longqijun/linetrace/自己测试用赛道.jpg

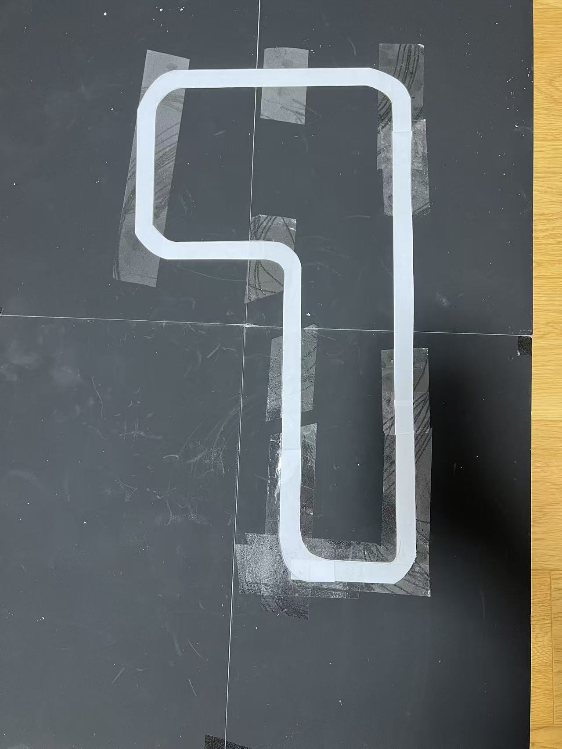
自己测试用赛道.jpg
