longqijun/linetrace/公司比赛用赛道.jpg

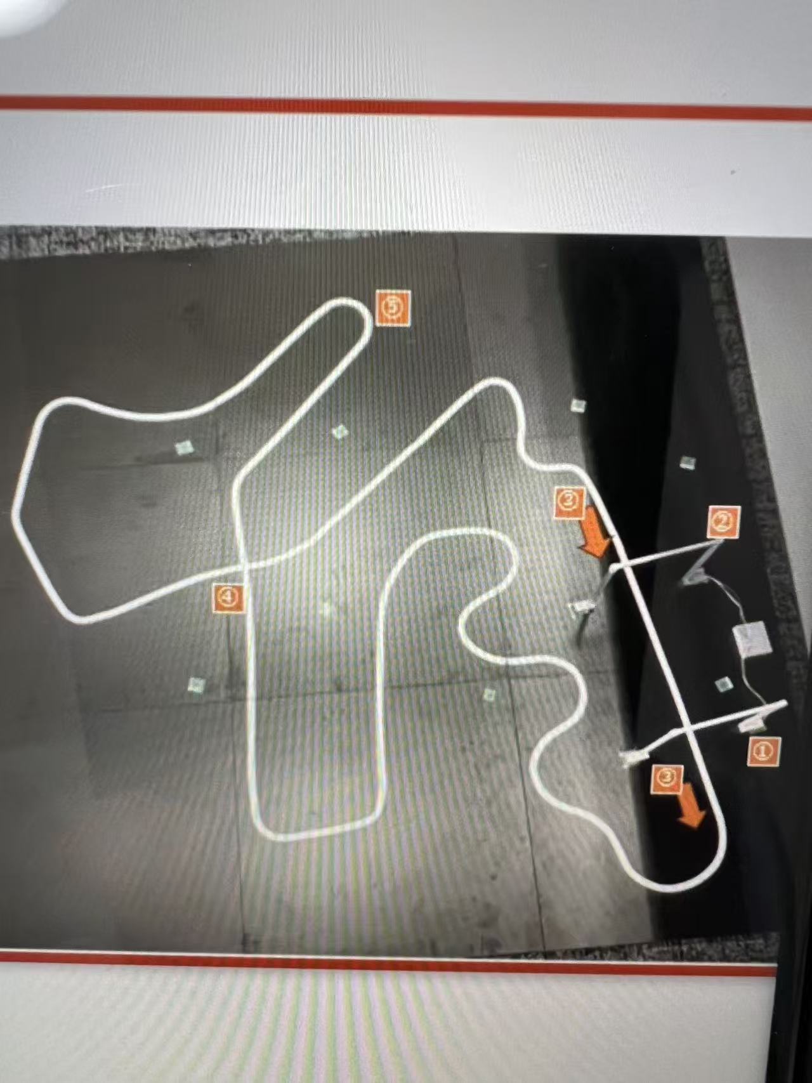
公司比赛用赛道.jpg
