longqijun/linetrace/doc/README.md

# 文档索引

巡线小车项目文档，按类别整理。原始代码在仓库根的 `sensor_debug/`。

## 设计（架构与算法）— `设计/`
| 文档 | 内容 |
|---|---|
| [设计说明](设计/设计说明.md) | 项目总体设计说明 |
| [主程序到bangbang算法调用流程](设计/主程序到bangbang算法调用流程.md) | 主循环到巡线算法的调用链 |
| [8路传感器方案](设计/8路传感器方案.md) | 8 路传感器排布、二值/加权判定方案 |
| [8路模拟PID算法](设计/8路模拟PID算法.md) | 基于模拟量加权位置的 PID 方案 |
| [PID算法分析](设计/PID算法分析.md) | PID 参数与行为分析 |
| [BANGBANG算法修改方案](设计/BANGBANG算法修改方案.md) | 中心直行+对称三档的 bang-bang 改造方案 |
| [LOG精简方案](设计/LOG精简方案.md) | 内存日志格式与精简方案（modeCode/事件行等） |

## 硬件（电机 / 传感器 / 机械）— `硬件/`
| 文档 | 内容 |
|---|---|
| [如何判断当前有没有机械延迟](硬件/如何判断当前有没有机械延迟.md) | 机械 vs 软件延迟的判定实验；减速箱慢一拍分析；齿轮比 114.7/38.2/12.7 选择 |
| [电机选型_空心杯无刷](硬件/电机选型_空心杯无刷.md) | 空心杯/无刷电机选型，中/日品牌+链接 |
| [传感器前探设计](硬件/传感器前探设计.md) | 前探为何数据更乱、单排甜区、双排方案、找线改法 |
| [电池选型](硬件/电池选型.md) | 18650 双电源电池方案 |

## 调试（记录与排障）— `调试/`
| 文档 | 内容 |
|---|---|
| [调试记录](调试/调试记录.md) | **主进展记录**：从 log13 到 log20 的调试历程、结论与下一步 |
| [软件问题解决](调试/软件问题解决.md) | 软件问题排查记录 |

## 日志分析 — `日志分析/`
每份 `logNN.txt` 是抓取的原始数据，`logNN分析.md` 是对应分析。关键脉络（详见 [调试记录](调试/调试记录.md)）：

| 分析 | 结论要点 |
|---|---|
| [log13分析](日志分析/log13分析.md) | 老 bang-bang 从不进 STRAIGHT，居中被判 CROSS → 发散丢线 |
| [log14分析](日志分析/log14分析.md) | 改中心直行后仍漂；三根因（slew/找线反转/激进档） |
| [log15分析](日志分析/log15分析.md) | slew 600→5000 后直线不丢；**证明软件延迟是主因** |
| [log16分析](日志分析/log16分析.md) | PID 直线笔直，err ±0.33 内 —— **直线达标** |
| [log17分析](日志分析/log17分析.md) | 弯道 bang-bang 每弯必险；含**弯道降速方案A**详解 |
| [log18分析](日志分析/log18分析.md) | 方案A 第一版仍冲出；削弱了发卡内轮 |
| [log19分析](日志分析/log19分析.md) | 方案A 第二版（minpwm）按设计工作，但动不了 sharp/发卡 |
| [log20分析](日志分析/log20分析.md) | 跑最久 67s，但 sharpspeed 被 minpwm 吃掉无效；**软件到顶** |
| 早期 | [log4](日志分析/log4-分析报告.md)、[log5](日志分析/log5分析.md)、[log6](日志分析/log6分析.md)、[log10](日志分析/log10分析.md)、[log11](日志分析/log11分析.md)、[bangbang/](日志分析/bangbang/) |

## 其他 — `其他/`
| 文档 | 内容 |
|---|---|
| [WIFI_PLAN](其他/WIFI_PLAN.md) | WiFi 相关计划 |

---
> 当前结论（截至 log20）：直线已用 PID 攻克；弯道受**电机静摩擦死区**限制，软件方案A 动不了 sharp/发卡，重心转向"治盲目找线 + 传感器前探 + 降死区/齿轮比（硬件）"。详见 [调试记录](调试/调试记录.md)。
