longqijun/linetrace/doc/硬件/电池选型.md

# 电池选型：18650 → 干电池 替代方案

## 背景

比赛规则不允许使用锂电池（18650），只能用**干电池**。本文给出替代方案和选购要点。

---

## 现有供电架构（双 18650）

来自 `设计说明.md`，本项目是**双电池、两路独立供电**：

| 路 | 电池 | 中间环节 | 负载 |
|---|---|---|---|
| 逻辑路 | 18650 ①（3.7V） | 升压模块 → 5V | ESP32 + 8路传感器 |
| 电机路 | 18650 ②（3.7V） | DRV8833 直连 VM | 电机 |

**为什么要两路分开**：电机启停/堵转时电流冲击大、电压会瞬间下陷，如果和 ESP32 共用一块电池，会把逻辑电压拉低导致 ESP32 复位/死机。所以电机和逻辑各用一块电池隔离——**换干电池后这个隔离必须保留**。

关键器件电压范围：
- **电机**：额定 1.5~3V（原装设计就是 2 节 AA = 3V）
- **DRV8833 VM**：2.7~10.8V（很宽，不是瓶颈）
- **升压模块**：输入几伏都能升到 5V，4.5V 输入升 5V 是很小的升压、效率高

---

## 干电池替代方案（推荐）

用 **单3（5号）AA 干电池**，每路一个电池盒：

| 路 | 电池盒 | 电压 | 说明 |
|---|---|---|---|
| 逻辑路 | 3×AA | 4.5V | → 沿用现有升压模块升到 5V（4.5→5V 很轻松） |
| 电机路 | 3×AA | 4.5V | → 直连 DRV8833 VM，替代原 3.7V 的 18650 |

**为什么是 3 节（4.5V）而不是别的：**
- 3×AA=4.5V 最接近原来 18650 的 3.7V（新电池空载约 4.7V，带负载下陷后落到 ~3.5~4V），动力手感和原来接近；
- 电机额定 3V，4.5V 约 1.5 倍，和原来 3.7V 的超压幅度差不多，**不比现在更激进**，DRV8833 也在安全区；
- 4 节（6V）= 电机额定 2 倍，堵转电流风险大（急转内轮反转那一下最容易过流跳闸/发热），**不推荐**；
- 2 节（3V）正好等于电机额定，最保护电机，但比原来 3.7V 弱一点，可能觉得没劲。

> ✅ **所以你要买的就是「3 节 5 号（AA）电池盒」，一共 2 个**（逻辑路、电机路各一个）。

---

## ⚠️ 关键注意：干电池带电机的「掉压」问题

这是锂电池换干电池最大的坑，一定要知道：

- **碱性干电池内阻高**，电机堵转/急转时电流冲到 2A 以上（`设计说明.md` 实测 3V 时堵转 ~2.1A），此时电压会明显下陷，电机变没劲、电池也掉得快。
- 缓解办法：
  1. **软件限幅**：把 `motor_module.cpp` 的 `motor_level_to_pwm` PWM 上限压低（比如封顶 ~180 而不是 255），减小峰值电流冲击——`设计说明.md` 里已经讨论过这个折中；
  2. **电机路用容量大的电池**：5号(AA) 是平衡之选；如果动力/续航不够，电机路可换 **2号(C) 或 1号(D)** 干电池盒（内阻更低、能出更大电流），代价是更大更重；
  3. 用**新的、好的碱性电池**，电机路掉得比逻辑路快，注意及时换。

---

## 备选：镍氢充电电池（NiMH，需先确认规则）

如果规则里「不能用锂电池」但**允许镍氢**（NiMH 是可充电，但不是锂），那它其实比碱性干电池更适合带电机：
- 内阻低、能扛大电流、掉压小，很适合电机负载；
- 单节标称 1.2V，**4 节 = 4.8V**（接近本方案的 4.5V），电池盒买 4 节的。

> ❗ 但你说「只能是干电池」，NiMH 属于充电电池、可能不算干电池——**买之前先跟规则/裁判确认镍氢是否允许**。允许就优先用它，不允许再用碱性。

---

## 选购要点 + 链接

买电池盒时挑这些特征：

- **3 节 5 号（AA）串联**，输出 4.5V（这类盒子默认就是串联）
- **带开关**（方便整车断电，省得每次拔电池）
- **带引线**（红黑线，直接焊/接线）或 **带 DC 插头**（5.5×2.1mm，看你板子接口）

淘宝 / 京东搜索链接（搜索页比单品链接稳，不会因为下架失效）：

- 淘宝：<https://s.taobao.com/search?q=3节5号电池盒+带开关>
- 京东：<https://search.jd.com/Search?keyword=3节5号电池盒%20带开关>
- 关键词也可以搜：`3节AA电池盒 带开关 引线`、`4.5V电池盒 DC插头`

如果决定电机路用大电池：

- 淘宝：<https://s.taobao.com/search?q=3节1号电池盒+带开关>（1号=D，大电流）
- 或 2 号(C)：`3节2号电池盒`

镍氢方案（4 节 4.8V）：

- 淘宝：<https://s.taobao.com/search?q=4节5号充电电池盒>

---

## 小结

| 场景 | 买什么 | 数量 |
|---|---|---|
| 标准方案（碱性干电池） | 3 节 5 号(AA) 电池盒，带开关 | 2 个（逻辑/电机各一） |
| 电机没劲/续航短 | 电机路换 3 节 2 号(C) 或 1 号(D) 盒 | 电机路 1 个 + 逻辑路 3×AA 1 个 |
| 规则允许镍氢 | 4 节 5 号盒 + NiMH 电池 | 2 个 |

换电后建议先按上面「软件限幅」把 PWM 上限压低再上车，避免干电池掉压 + 急转过流。
