longqijun/linetrace/doc/日志分析/log31分析.md

# log31 分析（PID kp80/kd20：目前最好的一套）

> 背景：log30(kp130) 过转变差后，回到 **kp=80、把 kd 拉高到 20**（新建档 `algo_pid`）。参数：PID speed15, kp80, ki0, **kd20**, slew5000（base≈96）。用户：**这套参数还好一点。**

## 一、✅ 目前最好的结果
| 指标 | BB(log21-27) | log28 kp80/kd15 | log29 kp80/kd15 | log30 kp130/kd6 | **log31 kp80/kd20** |
|---|---|---|---|---|---|
| 结局 | 60~130s | ~2s 冲飞 | 80s | 16s | **129s（80s无撞停）** |
| **LOST 占比** | 19.6~22.7% | 45% | 29.8% | 52.3% | **18.5%** |
| LOST_STOP | 有 | 有 | 少 | 有 | **0（logged 80s）** |
| 外轮封顶 | — | ✗(226) | ✓96 | ✓96 | ✓96 |

- **LOST 18.5% 是所有跑（PID+BB）里最低的**，且 logged 80s 内**一次都没撞停**，车跑到 129s。
- 丢线不再"全在左"：**LOST_L=699、LOST_R=819**，基本平衡——说明左弯现在**跟得住**了，剩下的丢线是小幅过冲（左右都有一点），而不是"每个左弯必翻"。

## 二、为什么 kp80/kd20 比之前都好
- **kp 保持中等(80)**：不像 kp130 那样稳态过转（不会一进弯就猛掰过头）。
- **kd 拉高到 20 = 预判式转向**：kd 对"误差变化率"响应。**线快速往边缘扫时（=正在进弯），微分尖峰把内轮狠狠反转**（本趟内轮瞬时到 **-173**），给一个"该使劲时才使劲"的强 pivot；而 err 稳定时又很温和。
- **外轮封顶让高 kd 变安全**：log28 时 kd 尖峰会把**外轮**顶到 2 倍多 base（加速冲飞）；现在外轮封顶 96，**同样的 kd 尖峰只作用在内轮（反转）**——正好是"进弯狠掰内轮、外轮不加速"的理想动作。所以**"外轮封顶 + 高 kd"是这次能跑好的关键组合**。

一句话：kp80 给温和的稳态跟随，kd20 给进弯瞬间的强反转 pivot，外轮封顶保证这股劲只用来转、不用来冲。

## 三、仍有空间
- LOST 18.5% 虽是最低，但还不算"稳当"（理想是个位数）。可微调再往下压：
  - kp 小幅上探（80→90）看弯道是否更跟得住、会不会又过转；
  - 或 speed 略降（15→13）给点裕量；
  - kd 已经 20，别再大幅加（太大对噪声敏感、会发毛）。
- 一次只动一个，跑一趟看 LOST%。
- 缓冲 80s 写满看不到后半程；想看完整 129s 一趟可临时 `lograte 15`。

## 四、结论
**`kp80 / kd20 / 外轮封顶` 是目前最优基线**：LOST 18.5%（最低）、80s 无撞停、左弯跟得住。机理=温和 kp + 高 kd 预判反转 + 外轮封顶。下一步在此基础上小幅微调（kp→90 或 speed→13）把 LOST 压到个位数即可。

---
相关：`log30分析.md`(kp130过转)、`log29分析.md`(kp80欠转)、`../问题/02_PID外轮boost加速冲弯.md`(外轮封顶)
