longqijun/linetrace/doc/日志分析/log26-27分析.md

# log26 / log27 分析（speed 18 vs 19 对比，loop 卡顿修复后）

> 背景：用**算法管理器**新建了两个命名档做速度对比——`bb_18`(id3, speed18) 与 `bb_19`(id4, speed19)，其余参数相同（turn_ratio=1.0, sharp=-0.4, xsharp=-0.6, shpspeed/hpspeed=1.0, minpwm=70, slew=50000, lograte=10）。算法管理器正好用来做这种 A/B。

## 一、loop 卡顿修复：继续稳固 ✅
| | log26 (spd18) | log27 (spd19) |
|---|---|---|
| H 间隔 ≥40ms（卡顿） | **0** | **0** |
最大 H 间隔都是 10~11ms。修复（去掉 `out()` 的持续 flash 写）在 speed18/19 下依旧零卡顿。

## 二、speed 18 vs 19 对比
| 指标 | log26 `bb_18` | log27 `bb_19` | 趋势 |
|---|---|---|---|
| **LOST 占比** | **19.6%** | **22.0%** | 速度越高丢线越多 |
| LOST_L / LOST_R | 1253 / 763 | 1397 / 861 | 都偏左（见第四节） |
| HAIRPIN(7/8) 次数 | 1834 | **2093** | 越快越容易冲到发卡边缘 |
| STRAIGHT(0) 次数 | 2541 | 2212 | 越快直行占比越少（一直在修正） |
| CROSS(9) | 5 | 4 | cross 收紧有效 |
| logged 97s 内 LOST_STOP | 0 | 0 | 两趟前 97s 都没撞停 |

**结论：speed 19 明显比 18 更 marginal**——丢线率更高（22% vs 19.6%）、发卡更多、直行更少。速度提高必然放大过冲/丢线。**18 比 19 稳一点。**

## 三、两趟都"没撞停"，但看不到结局
- log26：`elapsed=121072ms  duration=96734ms`，缓冲 ~97s（10298 行）写满截断；结尾停在**左发卡**挣扎中（`C0 7 -69 115`），非撞停。车实际跑到 121s。
- log27：`elapsed=135988ms  duration=97168ms`，同样 ~97s 写满；结尾停在**左侧找线**（`00 A -48 121`），非撞停。车实际跑到 136s。
- 前 97s 都没 LOST_STOP，延续 log25"卡顿修复后跟得住"的趋势——但**缓冲截断看不到后半程**，无法确认最终是否撞停。要看完整趟，可临时 `lograte 15~20`。

## 四、值得注意：持续"偏左"
两趟 **LOST_L 都明显多于 LOST_R**（1253:763、1397:861），和之前多次观察一致（第一次漂总偏左、左发卡更难缠）。疑似**轻微左偏**——可能来源：左右轮不一致（传动/PWM 响应）、或最外侧传感器标定。
- **建议单独验证**：原地 `spin left`/`spin right` 各转固定时间比转角；或同 PWM 直行测跑偏方向。若确有固定左偏，`../硬件/如何判断当前有没有机械延迟.md` 方向2（传动比/编码器）值得推进。

## 五、结论与下一步
1. **卡顿修复在 18/19 下都稳**（零大间隔）。
2. **速度 18 比 19 稳**；但两趟都还是 ~20%+ 丢线、没裕量。
3. 要把"惊险续命"变成"稳当跑完"：**弯道降速**（`shpspeed`/`hpspeed` 从 1.0 降到 0.6~0.7）或整体降速，把 LOST 占比压到个位数——比继续加速更重要。
4. **查左偏**：LOST_L 系统性多于 LOST_R，先确认是不是左右轮/标定不对称。
5. 想看完整一趟结局：`lograte 15~20` 让缓冲录满 >130s。

---
相关：`log25分析.md`(卡顿修复首测)、`log21-22分析.md`(marginal/运气)、`../问题/01_loop周期性卡顿(flash文件日志).md`、`../设计/算法管理单元设计.md`
