longqijun/linetrace/doc/日志分析/log21-22分析.md

# log21 / log22 对比分析（同代码同赛道，为何一个13圈一个4圈）

> 背景：只改了 cross 判定逻辑（见 `log解析答疑.md` Q4）后，在**同一封闭跑道**（约 10s/圈）连跑两趟。log21 跑了 ~133 秒，log22 只跑了 ~48 秒。用户疑问：同代码同赛道，为什么差这么多？

## 一、先确认：两趟配置完全相同
两个 PARAMS 一字不差：
```
speed=16 algo=BANGBANG turn_ratio=1.00 medium_ratio=0.65 sharp_ratio=-0.40 xsharp_ratio=-0.60
medspeed=0.90 shpspeed=1.00 hpspeed=1.00 minpwm=70 slew_rate=50000.0 pid_kp=41 pid_ki=1 pid_kd=5
```
代码也只差 cross 那点改动。**所以差异不是配置/代码造成的。**

## 二、关键数据：两趟都在"刀尖上跑"
| 指标 | log21 | log22 |
|---|---|---|
| 挂钟时长 | 133.6s（~13 圈） | 48.2s（~4-5 圈） |
| 数据行数 | 1759 | 497 |
| **LOST(A/B) 占比** | **20.0%** | **22.5%** |
| 结束方式 | LOST_L(00 A) → LOST_STOP | LOST_L → LOST_STOP |
| TRACK_ON t | 1230 | 11510 |

档位分布（次数）：
| | STRAIGHT0 | CROSS9 | MED3/4 | SHARP5/6 | HAIRPIN7/8 | LOST_L(A) | LOST_R(B) |
|---|---|---|---|---|---|---|---|
| log21 | 391 | 237 | 317 | 283 | 175 | 164 | 188 |
| log22 | 78 | 5 | 115 | 119 | 63 | 55 | 57 |

**两趟丢线率几乎一样（20% vs 22.5%）**——每 5 个记录状态就有 1 个是"丢线"，靠找线勉强救回。每个发卡都是一次"救得回 / 甩出去"的掷硬币。失败模式也相同：都在**左发卡处 LOST_L 后停**。

## 三、为什么同代码一个 13 圈一个 4 圈？
因为这套控制**几乎没有稳定裕量**（20% 丢线率 = 常年在崩溃边缘）。这种**临界稳定 / 近乎混沌**的系统，结局由一堆**无法复现的微小差异**决定：

1. **起跑位置/角度**：按 track on 时车头偏一点点，几圈后累积到某个发卡就翻。
2. **电池电压**（最易忽略的大变量）：电压高=扭矩/速度大=动力学不同；一趟 2 分钟本身在掉压。log22 的 `TRACK_ON t=11510` 比 log21 的 `t=1230` 晚，若同一节电池连跑，log22 时电更虚。
3. 轮子抓地/灰尘/电机温度、以及**每个发卡进入相位的累积**：某圈进弯稍差一点 → 丢 → 甩飞。

**结论：同样的代码不保证同样的结果**——系统没有裕量时，跑 4 圈还是 13 圈基本是运气。cross 改动与这个差异无关。

## 四、根子：这套参数太激进、没留裕量
- `turn_ratio=1.00`（急弯外轮不降速）、`shpspeed=1.00 hpspeed=1.00`（方案A弯道降速全关）、`sharp_ratio=-0.40`（内轮反转更狠）、`slew=50000`（不平滑）——**全是"冲"的方向，弯道一点没收速** → 必然高频冲过头 → 20% 丢线。

## 五、建议
**要让"能跑完"从靠运气变成可复现，就得给系统裕量：**
1. **弯道降速**：把 `shpspeed`/`hpspeed` 从 1.00 降下来（如 0.7/0.6），或用 `turnspeed` 让急弯外轮降速。代价是牺牲点圈速，换来把 20% 丢线率压下去。
2. 治**盲目找线**（每次甩飞的直接扳机，见 `log20分析.md`）。
3. 硬件裕量：让车能跑更慢（降死区 / 降齿轮比，见 `../硬件/如何判断当前有没有机械延迟.md`）。

判据：盯 **LOST 占比**。现在 20%+ = 没裕量、看运气；把它压到个位数，才算"稳定能跑完"，而不是"这趟运气好"。

---
相关：`log20分析.md`、`log17分析.md`、`log解析答疑.md`
