longqijun/linetrace/doc/日志分析/log19分析.md

# log19 数据分析报告（方案A第二版：minpwm=70 生效，仍在发卡弯冲出）

> 背景：flash 了第二版代码（带 `minpwm` + 内轮反转恢复满速 base）后跑弯道。PARAMS 确认 `minpwm=70`，三档速度仍全 0.85。
> 参数：speed=17, algo=BANGBANG, medium_ratio=0.65, sharp/xsharp=-0.20/-0.60, medspeed/shpspeed/hpspeed=0.85, **minpwm=70**, slew=5000。
> 运行 28.7s，其中**最后约 8s 是冲出赛道后在全白区(FF)直行空跑**，真正在赛道上约 **20s**。

## 一、第二版代码确认按设计工作 ✅

| 检查项 | 期望(v2) | 日志实测 | 结论 |
|---|---|---|---|
| 发卡外轮加地板 | 降速后35→抬回70 | 行48/129 `C0 7 -64 70`、行49 `40 5 -21 70` 外轮=70 | ✅ minpwm 生效 |
| 发卡内轮恢复满速 | -64（不再是v1的-54） | 行129/244 `C0 7 -64 70`、行140/235 `03 8 70 -64` 内轮=-64 | ✅ 掉头力度已恢复 |

两个修正都到位了：外轮不再掉到 59 堵转、发卡内轮反转恢复到 -64。

## 二、但结果：仍在发卡弯 thrash-off 冲出，和 log17/18 同一个坑

约 20s 在赛道上，`LOST`（`00 A/B`）出现 **25+ 次**，最后（行 249–273）又是熟悉的剧本：
```
0F 8(发卡) → 06 6 → 00 B(丢) → E490盲目找线 → 00 A(甩到另一侧又丢)
→ C0 7 / 40 5 / C8 在CH8/CH7区高频反转乱掰(-54/-64) → FF(全白,冲出赛道)
```
冲出后进入全白区，代码把 FF 当 CROSS→108/108 直行，于是空跑了 ~8s 才被关掉（行 273–288 一串 `FF 9 108 108`）。

## 三、关键认识：方案A 在这台电机上**动不了发卡弯**——已被 log17/18/19 三次证实

对比 log19(v2) 和 log17(无方案A)，**除了 MEDIUM 档，其余完全一样**：

| 档 | log17(无方案A) | log19(v2, 全0.85+minpwm70) | 差异 |
|---|---|---|---|
| MEDIUM 外轮 | 108 | 91 | log19 慢 15% |
| SHARP 外轮/内轮 | 70 / -21 | 70 / -21 | **完全相同** |
| HAIRPIN 外轮/内轮 | 70 / -64 | 70 / -64 | **完全相同** |

原因：全 0.85 的降速让 sharp/发卡外轮算出来是 ~59，**被 minpwm=70 地板抬回 70**，内轮又是满速——于是**和原始行为一模一样**。**方案A 唯一改变的是 MEDIUM 外轮 108→91，对 sharp/发卡毫无作用。**

> 换句话说：**在你这台电机的死区限制下，软件方案A 根本没有空间去降 sharp/发卡的速度**——外轮本就贴着死区地板(~70)，再降就堵转。这不是参数没调好，是物理上没空间。log17/18/19 三次不同代码/参数，发卡失败模式一字不差，就是铁证。

## 四、真正的墙：速度降不下来，发卡就过不去

- 车能跑的**最低速度就是 speed 16（PWM~102 起步、运动中外轮~70）**，再低就堵转停车。
- 发卡弯需要**更慢**才能转过来，但你**降不到那么慢**——这是死区造成的硬墙。
- 所以：**不是算法不会转，是车在这个速度下物理上转不过这些发卡弯**，一冲就过头、丢线、盲目找线甩出去。

## 五、下一步：软件到顶了，重心转向"能不能更慢" + 找线

**软件层（还能榨的）：**
1. **治盲目找线**（每次冲出的直接扳机）：丢线后别再大幅反转赌方向。改成"延续上一档、幅度更小"或"缩短 LOST 超时更早停"，至少别把车主动甩出赛道。
2. **传感器前探**：往车头前移，更早看到发卡、更早开始掰，争取在冲到边缘前就转。
3. 差异化系数意义不大了（sharp/发卡被地板顶着），可先不折腾。

**硬件/根子层（真正的解法）：**
4. **降低电机死区 = 让车能跑更慢**（这是最对症的一条）：
   - 提高 PWM 频率（`analogWrite` 频率高一些，能减小有效死区、让低占空比也能转）；
   - 或"起步踢一脚"（kickstart：先给一下高 PWM 冲过静摩擦再落到低值），让最低可用速度下探；
   - 或换低 stiction 的电机/驱动。
   - **只要能稳定跑到比现在更慢，方案A/降速立刻就有用了。**
5. **齿轮比 / 车体**：见 `如何判断当前有没有机械延迟.md` 第七节；或确认这些发卡半径是否本就超出车在最低速度下的转弯能力。

> 注意：**PID 也救不了发卡**——kp=40 时内轮最多降到 68、不反转，发卡更转不过来（要反转得把 kp 提到很高，直线又会躁）。发卡这种紧弯，bang-bang 的反转其实是对的，问题纯粹是"太快 + 找线甩飞"。

## 六、一句话

第二版代码（minpwm=70 + 满速内轮）**按设计正确工作了**，但**没改变结局**——因为方案A 在死区限制下动不了 sharp/发卡（外轮被地板顶在 70，和原始一样）。log17/18/19 三次证明：**发卡失败是"速度降不下来"的硬件墙，不是软件参数问题**。下一步软件上只值得做"治盲目找线 + 传感器前探"，真正的解法是**想办法让车能跑得更慢**（降死区/踢一脚/换驱动）或**降齿轮比**。

---
相关文档：`log分析/log18分析.md`、`log分析/log17分析.md`、`如何判断当前有没有机械延迟.md`、`调试记录.md`
