longqijun/linetrace/doc/日志分析/log20分析.md

# log20 数据分析报告（sharpspeed=70，跑最久 67s，仍发卡冲出）

> 背景：弯道测试，把 `sharpspeed` 调到 **70**（others 0.85, minpwm=70）。运行 **67.7 秒 / 约 938 行（缓冲区快写满）**，是目前跑最久的一次，最后仍冲出赛道(FF)。
> 参数：speed=17, algo=BANGBANG, medium_ratio=0.65, sharp/xsharp=-0.20/-0.60, **medspeed=0.85 shpspeed=0.70 hpspeed=0.85**, minpwm=70, slew=5000。

## 一、先说一个扎心的事实：你把 sharpspeed 调到 70，但它**一点作用都没有**

sharp 外轮 = `floor_fwd(base × sharpspeed × turn_outer)`：

| sharpspeed | 外轮算出来 | 过 minpwm=70 地板 | 实际 |
|---|---|---|---|
| 0.85（log19） | 108×0.85×0.65 ≈ 59 | 抬回 **70** | 70 |
| **0.70（log20）** | 108×0.70×0.65 ≈ 49 | 抬回 **70** | 70 |

sharp 内轮又是满速 `108×(-0.2)=-21`（不受 sharpspeed 影响）。**所以 sharpspeed 从 85 调到 70，电机实际收到的指令一个数都没变**——两次的 sharp 完全一样（外轮 70、内轮 -21）。

**结论：在 speed=17 下，sharpspeed / hairpinspeed 都被 minpwm 地板吃掉了，调它们等于没调。** 这也解释了 log20 为什么和 log19/log17 行为一致。

## 二、跑了 67s 是"最久"，但不是方案A的功劳，是运气 + 回到原始行为

- log20(67s) ≈ log17(64s，**完全没有方案A**)。因为 sharp/发卡都被地板顶回原始值，**log20 的实际行为 = 原始 bang-bang**，只有 MEDIUM 外轮 91(vs 108)。
- 67s vs log19 的 20s 的差别，是**在哪个发卡上翻车的运气差异**，不是参数变好了。软件这几版对 sharp/发卡的实际输出没动过。

## 三、仍然是老问题：发卡处反复长时间 thrash，最后一次没救回来

全程几十次 `LOST`，多处出现**发卡卡住、原地反转找线好几百毫秒甚至上千毫秒**才勉强脱困：
- 行 42–99：一段发卡+LOST_L 连续乱掰约 2–3 秒（C0/80/40/00A 反复，PWM 一直负）才在行 100 恢复。
- 行 761–807：更夸张，LOST_L 里反转找线一路掰到 **行 807 `E1011 01 8`（dt=1011ms）** 才找回线——**离 1500ms 丢线停车只差一点**。
- 最后（行 943–951）：`0F 8`(发卡)→`1F 9`→`FF`(全白冲出赛道)。同一个死法。

**每个发卡都是几百毫秒~1秒的"原地打转赌线在哪"**，赌对了续命、赌错了飞出去。67s 是赌对了很多次，直到最后赌错。

## 四、一个值得注意的现象：左发卡(LOST_L)更难缠

长时间 thrash 大多是 `00 A`(LOST_L) + `80/C0/E0 7`(左发卡)。右侧(LOST_B)相对短。可能是：① 轻微左偏(和之前"总偏左"一致)；② 或赛道左发卡更紧。**建议单独确认左右是否对称**（原地 spin 左右各转一圈看角速度，或方向2测左右轮）。

## 五、诊断与下一步（和 log19 一致，进一步坐实）

**已坐实**：log17/18/19/20 四次证明——**软件方案A 动不了 sharp/发卡**（被 minpwm 地板顶死），发卡失败是"速度降不下来"的硬件墙。调 sharpspeed/hairpinspeed 在 speed=17 下**无效**，别再花时间调它们。

**软件上还值得做的（只剩两条）：**
1. **治盲目找线**（每次飞出去的直接扳机，也是那些 1 秒 thrash 的元凶）：丢线后别原地大幅反转赌方向。可考虑：找线幅度减小、或延续"丢线前最后一个转向档"而不是猛反转、或缩短 LOST 超时更早停（宁可停也别甩出赛道）。**这是当前最该改的软件项。**
2. **传感器前探**：更早看到发卡、更早开始掰，减少冲到边缘丢线的概率。

**根子（真正解法）：**
3. **让车能跑更慢**（降死区：提高 PWM 频率 / 起步踢一脚 / 换低 stiction 驱动）——只要能低于 speed 16 稳定跑，方案A/降速立刻生效，发卡也能慢下来转。
4. **降齿轮比 / 确认发卡半径是否超出当前最低速的转弯能力**。

## 六、一句话

log20 跑了最久(67s)，但那是因为 **sharpspeed=70 被 minpwm 地板完全吃掉、行为退回原始 bang-bang + 运气好**，不是方案A起了作用。**在 speed=17 下 sharpspeed/hairpinspeed 无效，别再调。** 发卡处反复上千毫秒的盲目反转找线是续命也是致命点——**下一步软件只做"治找线 + 传感器前探"，真正解法是让车能跑更慢（降死区/齿轮比）。**

---
相关文档：`log分析/log19分析.md`、`log分析/log17分析.md`、`如何判断当前有没有机械延迟.md`、`调试记录.md`
