longqijun/linetrace/doc/日志分析/log11分析.md

# log11.txt 分析报告

**背景**：用户反馈"PID算法完全都跑飞了"。`log11.txt`是紧接着`log10`之后的一次测试，切到PID模式，`track on`没多久车就丢线停摆，`track off`后`log dump`取出的内存log。

配置（`PARAMS`行）：`algo=PID speed=17 pid_kp=40.00 pid_ki=0.00 pid_kd=0.00 slew_rate=5000.0`（`turn_ratio`/`medium_ratio`/`sharp_ratio`/`xsharp_ratio`是bang-bang专用参数，PID模式下不生效，可以忽略）。

时间线：`TRACK_ON t=417794` → `TRACK_OFF t=435476`，`elapsed=17682ms`（约17.7秒）、`duration=17220ms`、`lines=113`。全程没有真正稳定跟踪超过1秒，最后连续丢线触发`LOST_STOP`彻底停摆。

---

## 1. 核心发现：`Kd=0`，PID完全没有阻尼，纯比例控制在裸奔

`pid_kd=0.00`——微分增益是0。项目`track_module.cpp`里`PID_KD_DEFAULT`定的默认值是`5.0`，这次测试相当于手动把阻尼项关掉了，只剩纯`P`（外加`Ki=0`，连积分都没有）。

纯比例控制在这种"位置传感器离散跳变+响应很快"的系统里天然容易振荡：误差一出现就立刻按比例全力修正，没有任何"预判减速"的机制去抑制修正过头，车一冲过线就是满力度回摆，再冲过去又是满力度回摆，跟`Kp`单独多大关系不大——`Kd`原本就是设计出来专门压制这种振荡的（`track_module.cpp`里"PID_DERIV_FILTER_ALPHA"那段注释写得很清楚，微分项就是为了不让离散误差的高频抖动被直接放大）。

---

## 2. 数据证据：误差摆幅大、且集中出现"原地打转"式的高频振荡簇

摘几段`err`字段的变化过程（`E`/`H`行末尾`%+.2f`那个数）：

```
t≈420~421秒: err从-0.08一路恶化到-0.70（第38行 E1025 80 P 80 136 -0.70）
随后几行反弹到+0.33、+0.34（第42、61行）
t≈429秒附近: err在+0.68附近（第83行）
```

误差在±0.7上下大幅摆动（这个误差是`sensor_position_analog_from()`算出来的-1.0~+1.0归一化值），说明车不是"轻微画龙"，是**大幅度冲出中心线再被强行拉回来**，跟纯P没有阻尼的预期表现完全吻合。

更能说明问题的是几段密集振荡簇，比如第71~81行（约550ms内）：

```
E2 0C P 96 120 -0.30
E2 48 9 101 115 -0.30
E2 08 P 96 120 -0.30
E4 48 9 101 115 -0.31
E8 08 P 98 118 -0.31
E4 48 9 101 115 -0.31
E2 08 P 96 120 -0.31
E10 48 9 107 109 -0.28
E2 08 P 97 119 -0.28
E14 48 9 108 108 -0.26
E2 08 P 98 118 -0.26
```

`dt`几乎全是2~14ms，在`PID`正常计算和`CROSS`判定之间来回跳了近10次，`err`死死卡在-0.26~-0.31之间纹丝不动——车在一个固定的偏移量附近来回小幅振荡，PID算出来的差速修正量没能把它拉回中心，反而形成了一个局部振荡死循环。第84~98行还有一段几乎一样的模式（这次是`err`卡在+0.23~+0.38之间）。

---

## 3. 最终失败序列：LOST_R持续超时，触发LOST_STOP

日志最后几行：

```
E26 00 B 122 74      <- LOST_R，车已经完全找不到线了
H500 00 B 108 -43    <- 延续右转找线，1500ms内共3次心跳
H500 00 B 108 -43
H500 00 B 108 -43
E1502 00 C 0 0        <- 丢线超过1500ms（LOST_TIMEOUT_MS），LOST_STOP，电机彻底停转
```

PID在这之前一直没能把车拉回线上（对照第2节的振荡簇，车其实已经在某个偏移点附近反复拉扯了一段时间），最终彻底冲出传感器能检测的范围，进入`LOST_R`持续搜索，1.5秒内没找回来就永久停车——这跟项目此前记录（`log6分析.md`：Kp=40时PID同样反复丢线，"基本没有办法使用"）是同一类失败模式，这次多了`err`数据能具体看到失控的幅度和振荡细节。

---

## 4. slew_rate同样是5000，PID这边影响更直接

跟`log10`（bang-bang）同一批参数，`slew_rate=5000`同样意味着PWM平滑基本不起作用。对PID来说这个影响更直接：PID本身连续计算出来的差速修正量，如果每次都不打折扣地立刻下发到电机，等于放大了"无阻尼纯P"带来的振荡——`Kd=0`已经让输出信号本身振荡，`slewrate`又没有帮忙抹平，两个问题叠加在一起。

---

## 5. 下一步调参建议（按优先级）

1. **先把`Kd`加回去**：`pid kd 5`（用回项目文档默认值），或者考虑到本次误差摆幅比较大，可以从`5`开始试，不够再往上加到`8~10`。这是本次最直接的根因，光加这一项就应该能看到振荡明显收敛。
2. **同时/紧接着把`slewrate`降下来**：跟`log10分析.md`给bang-bang的建议一样，`slewrate 300`先试一版——PID和bang-bang现在共用同一套PWM限速机制，这个参数对两边都有用，不用分开调。
3. **`Kd`调好之后再看要不要动`Kp`**：目前`Kp=40`是项目一直以来的默认值，`log6分析.md`当时建议过加大到100+但从没在重写后的PID实现上验证过——建议先把`Kd`这个更明确的问题解决了、跑一次看效果，如果转向力度还是不够（修正跟不上、还是慢慢飘出去），再单独试着调大`Kp`，不要一次连着两个参数一起改。
4. **PID目前仍然是"未验证可用"的状态**（项目历次记录都是丢线/振荡），建议以bang-bang（`log10分析.md`）为当前主力调参对象，PID这边按上面3步先把`Kd`/`slewrate`这两个明显缺失的地方补上，再决定要不要投入更多精力继续调，别让两条线同时占用测试时间。
