longqijun/linetrace/doc/日志分析/bangbang/log-algo0-2分析.md

# log-algo0-2.txt 分析报告

**背景**：按`log-alg0-1分析.md`的建议——`slewrate`从300回调到中间区间——这次实车测试用的是
`slewrate 600`（在上次失败的300和历史默认值800之间取值）。

配置（`PARAMS`行）：`algo=BANGBANG speed=17 turn_ratio=0.65 medium_ratio=0.35
sharp_ratio=-0.40 xsharp_ratio=-0.60 slew_rate=600.0`——跟`log-alg0-1`相比**只有
`slew_rate`这一个参数变了**（300→600），`pid_kd`从0.00变成5.00但当前是BANGBANG算法，
这个字段不参与计算，可以忽略；`speed`/`turn_ratio`/`medium_ratio`/`sharp_ratio`/
`xsharp_ratio`/8路阈值/白黑参考值全部相同，仍然是一次干净的单变量对照。

时间线：`TRACK_ON t=209597` → `TRACK_OFF t=232299`，`elapsed=22702ms`
（约22.7秒）、`duration=22654ms`、`lines=236`。**全程只触发了1次`LOST_STOP`**，
发生在track on之后约20.15秒（第241行）。

---

## 1. 核心结论：`slewrate 600`把`300`那次的发散振荡问题解决了

对照三次测试的`LOST_STOP`次数和存活时长：

| 测试 | slew_rate | 运行时长 | LOST_STOP次数 | 平均无故障间隔 |
|---|---|---|---|---|
| log10 | 5000 | 110秒 | 1次 | 110秒 |
| log-alg0-1 | 300 | 19.4秒 | 3次 | 约5~9秒/次 |
| **log-algo0-2（本次）** | **600** | **22.7秒** | **1次** | **约20.15秒** |

`log-alg0-1分析.md`诊断出的问题是：`slewrate=300`把响应拖得太慢（从直行平滑到发卡弯目标
需要约0.58秒），车在半秒的滞后期里继续往外冲，导致每一次修正都比上一次更极端，5秒左右就
彻底发散丢线，19.4秒内重复了3次。这次把`slewrate`调到600之后，**这种"越摆越大、最终冲出
传感器范围"的发散模式没有再出现**——全程22.7秒只在最后真正丢线1次，而且丢线前的振荡幅度
（下面第2节）没有表现出log-alg0-1那种逐步扩大的趋势，是稳定的、有界的来回摆动。

`600`介于`300`（滞后发散）和`5000`（几乎不限速、边界处硬跳变高频抖动，见`log10分析.md`）
之间，这次实测结果支持"`slewrate`存在一个中间甜点区间，600这个点明显优于两头"的判断。

---

## 2. 全程振荡形态：有界摆动，不是发散

统计全部223条模式切换（`E`行）的`modeCode`分布：

| modeCode | 含义 | 次数 |
|---|---|---|
| 2 | RIGHT缓转 | 45 |
| 9 | CROSS | 41 |
| B | LOST_R | 33 |
| 5 | SHARP_L | 28 |
| 4 | MEDIUM_R | 16 |
| 3 | MEDIUM_L | 14 |
| 7 | HAIRPIN_L | 13 |
| 8 | HAIRPIN_R | 12 |
| 6 | SHARP_R | 11 |
| A | LOST_L | 9 |
| C | LOST_STOP | 1 |

22.7秒里发生了223次档位切换（约9.8次/秒），car持续在"缓转→中转→急转→发卡弯"之间左右
穿梭——这跟log-alg0-1的振荡"素材"是同一种（都是bang-bang在检测边界附近自然的来回切档），
区别在于**这次连续穿梭了20秒都没有发散**，而log-alg0-1平均5~9秒就崩一次。可以理解为：
600这个slew速率下，车每次冲到发卡弯（`HAIRPIN_L`/`HAIRPIN_R`共25次）之后都能在合理时间内
被拉回来，没有出现"PWM追赶目标太慢、车已经跑更偏"的滞后累积。

**LOST_L/LOST_R（A/B，共42次）里有一半左右是单次循环的瞬时噪声**：42次里有21次
`dt=2ms`（即触发后立即在下一次采样恢复正常，还没来得及有实质性动作就结束了），这跟
`log-alg0-1`（也有类似瞬时A/B）是同一种现象——大概率是传感器某一瞬间8路同时读到全黑
（`patHex=00`）的噪声毛刺，紧接着下一次采样又恢复了。因为`slewrate`限制了PWM变化速度，
这种2ms级别的瞬时丢线在实际电机输出上几乎看不出变化（占空比来不及跟着切换），**不是本次
需要处理的问题**，但如果以后想减少log噪声/减少不必要的`pid_reset()`调用，可以考虑给`lost`
判定加一个"连续N次采样都全黑才算真丢线"的去抖，而不是单次采样即触发。

---

## 3. 最终这次LOST_STOP：发卡弯打满后真正冲出检测范围

第235~241行，最后一次失控前的完整序列（约cum 18.4s起）：

```
t'≈18.41s  MEDIUM_R(4)   L=72  R=107
t'≈18.49s  SHARP_R(6)    L=107 R=61
t'≈18.52s  HAIRPIN_R(8)  L=84  R=38   ← 右侧打到最狠一档
t'≈18.65s  LOST_R(B)     L=71  R=-36  ← 传感器读到全黑(patHex=00)
             (持续两个500ms心跳，PWM维持在LOST_R的sharp_turn附近)
t'≈20.15s  LOST_STOP(C)  L=0   R=0    ← 超过1.5秒仍未找回，停车
```

跟前面反复出现的"中转→急转→发卡弯→找到线→回正"这个模式相比，唯一的区别是这一次
`HAIRPIN_R`之后没有像其他约25次那样重新读到白线，而是直接进入`LOST_R`并在1.5秒内
没能找回。全程只在最后一次发卡弯之后失败，此前所有的发卡弯（含另外24次）都成功回正，
这更像是"车这一次真的冲出了传感器物理检测范围"（比如track这一段的实际弯道比其余弯道
更急，或者车速/入弯角度的偶然组合导致这一次没找回来），而不是`slewrate`/差速参数本身的
系统性缺陷——如果是系统性问题，应该会在前面20秒里已经反复复现，而不是撑到第26次发卡弯
才失败一次。

---

## 4. 下一步建议

1. **`slewrate=600`目前看是明显优于300和5000的一个点，建议先固定住这个值**，不用再往
   更低/更高的方向盲目试探——这次22.7秒只丢线1次，已经是三次测试里最好的结果，值得作为
   下一步调参的基线。
2. **重点排查最后这次`HAIRPIN_R`失败**：如果条件允许，建议在同一段测试赛道上标记出车辆
   最后失控的大致位置（结合`elapsed`时长倒推大概经过了几个弯），确认是不是track上确实
   存在一个比其余弯道更急的转角、当前`xsharp_ratio=-0.60`应对不了；如果是，可以针对性
   把`xsharpratio`从60%试着调到70~75%左右单独测这一个弯，其余参数不动。
3. **对比"是否每次都栽在同一个弯"**：如果条件允许连续多跑几趟`algo 0`+同样参数，观察
   `LOST_STOP`是否总发生在整条赛道的同一位置附近——如果是，指向track本身某个特定弯道
   参数不够；如果每次失控位置都不一样，则更可能是偶发的角度/速度组合，优先级可以降低。
4. 瞬时A/B噪声（第2节）暂不需要处理，除非后续发现它开始影响PID模式（`sensor_position_
   analog_from`丢线判定用的是另一套0.3权重阈值，跟这里bang-bang的8路全黑判定不是同一套
   逻辑，两边分开评估）。
