longqijun/linetrace/(commit log)

2026-06-26 init: add sensor debug code for AE-NJL5901AR-8CH
2026-06-26 feat: 蓝牙调试版，只用D35/VP两路中心传感器
2026-06-26 test: 无蓝牙电源测试，LED闪烁验证供电稳定性
2026-06-26 fix: 关闭欠压检测器解决传感器上电重启问题
2026-06-27 refactor: 将蓝牙功能拆分为独立模块 bt_module
    新增 bt_module.h/cpp，封装 BluetoothSerial；
    主程序通过 bt_begin/bt_connected/bt_send 三个接口调用。
2026-06-27 docs: 添加硬件信息文档README.txt
    记录传感器引脚映射、ADC类型、电源方案、蓝牙配置等关键硬件信息。
2026-06-27 feat: 新增5路传感器模块 sensor_module
    封装独立阈值检测、二值判断和加权位置计算；
    各路阈值根据实测黑白数据独立标定（CH6偏弱单独处理）。
2026-06-27 feat: 传感器输出同时显示原始值、W/B判断和阈值
    启动时打印各路阈值，循环输出格式改为 值+W/B，便于对照验证阈值准确性。
2026-06-27 feat: 新增BT命令行模块 cmd_module，支持回显和命令解析
    bt_module增加带退格回显的行读取；cmd_module处理print on/off/help命令；主程序根据cmd_print_enabled()控制连续打印。
2026-06-27 feat: 新增print_module集中控制输出，新增motor_module和电机调试命令
    - print_module: 统一输出开关，默认USB/BT均关闭，支持独立控制
    - motor_module: DRV8833驱动封装，GPIO17/18/19/21/22，支持PWM和1~10档
    - cmd_module: 新增go/back/stop/speed命令；print支持usb/bt独立控制
    - cmd reply()始终可见，数据流通过out()受print_module控制
2026-06-27 docs: 更新README.txt，完整记录所有模块接口和硬件信息
2026-07-04 fix: 命令行英文化+输入提示符+BT换行修复
    将cmd_module和monitor_test.txt中的日志/命令回复改为英文（README/注释保留中文）；
    新增命令行 >> 提示符；修复传感器数据行末尾缺少\r导致BT终端不换行的问题。
    [cmd_module.cpp, sensor_debug.ino]
2026-07-04 feat: 新增配置持久化(config_module)和自动巡线(track_module)
    speed档位可通过save命令持久化到/config.json，开机自动加载(默认3)；
    新增track on/off命令，CH4主力压线、CH3/CH5差速纠偏的巡线模式，stop命令同时退出巡线。
2026-07-04 feat: 配置JSON打印、阈值持久化+在线调整、Boot按钮巡线开关
    - config命令打印当前速度+阈值JSON，开机自动打印一次
    - save时5路阈值随速度一起写入/config.json，开机自动加载(无字段则用默认值)
    - 新增threshold CH VALUE命令，可在线调整单路阈值(仅内存，需save持久化)
    - Boot按钮(GPIO0)消抖后可直接切换track on/off，不必输命令
2026-07-07 debug: track_module增加急弯调试log，定位R70调头冲出问题
    打印时间戳+5路W/B图案+判定模式(STRAIGHT/LEFT/RIGHT)+实际下发PWM，
    节流30ms，用于确认小尺寸调头时差速逻辑失效的具体原因
    [track_module.cpp]
2026-07-07 feat: 巡线三级差速+丢线延续转向+十字路口直行
    CH2/CH6触发急转(内轮反转)应对R70急弯，CH3/CH5保持原有缓转；
    丢线后延续最后转向方向找线，超时(1.5s)停车；
    新增十字路口/宽线检测(左右两侧同时压线)，直行穿过不误判为急转
2026-07-07 docs: 补充机械结构改造提醒+阈值实测记录，log.txt加入gitignore
2026-07-07 feat: 新增spin left/right命令，原地旋转测试最小转弯半径
2026-07-08 fix: 传感器机械反装(180°)后同步代码左右映射
    传感器移到后轮轴约50mm处并物理反装，CH2/CH6左右互换：
    - track_module.cpp三级差速的左右通道index互换，调试log打印顺序同步
    - sensor_module.cpp加权位置符号取反，保持-1/+1对应物理左右不变
    - threshold/config.json阈值映射不受影响(仍按CH2~CH6接线走)
    [sensor_module.cpp, track_module.cpp]
2026-07-08 feat: 速度档位1~10扩展到1~40(4倍分辨率)
    原3档"跑不动"、4档"偏猛"之间没有更细的档位可选，扩展到1~40档
    线性对应PWM 0~255(原N档=新N*4档)，默认速度从3等比改为12。
    同步更新speed命令校验范围、config默认值、README文档。
    .gitignore: log.txt改为log*.txt，覆盖log1.txt等后续日志文件
2026-07-19 feat: R70急弯外轮同步降速，新增turnspeed命令+配置持久化，补充DESIGN.md
    实测机械改造后车速稍快过R70就冲出赛道，原因是急转只反转内轮、
    外轮仍满速带着直道动能冲弯。新增外轮速度比例参数(默认65%)，
    运行时用turnspeed N(0~100)调整，纳入config_module持久化(JSON新增turn_ratio字段)。
    新增DESIGN.md记录硬件/软件设计决策：电机7V超压供电风险评估、
    全部7个代码模块的职责与依赖关系分析。
2026-07-19 docs: 新增R70实测log-1.txt及分析报告(log分析/目录)
    log-1.txt由用户重命名归档，配套分析报告记录R70急弯实测过程；
    末尾丢线经用户确认是测试场地线不够长所致，非转弯失败，报告已按此更正。
    被.gitignore的log*.txt规则匹配，按用户要求强制加入版本库。
2026-07-21 feat: TURN_RATIO_SHARP改为运行时变量，新增sharpratio命令+配置持久化
    针对log-2实测发现的SHARP_R->LOST_R长丢线（逼近1500ms超时上限），
    急弯内轮反转比例从硬编码常量改成可通过sharpratio N命令在线调节，
    对称于已有的turnspeed，纳入config_module持久化；DESIGN.md补充本轮
    调参记录（sharp_ratio -0.3->-0.4）。
2026-07-21 docs: 新增公司比赛/自建测试两条赛道照片
2026-07-22 feat: 新增PID巡线算法，与bangbang并列可切换（默认bangbang）
    track_module新增第二种算法TRACK_ALGO_PID，用sensor_module新增的纯函数
    sensor_position_from()复用同一loop周期已采样的is_white[]算连续误差，
    避免重复采样ADC；PID输出直接叠加到左右轮PWM做差速修正，clamp到±255，
    积分限幅防饱和。丢线/十字路口判定两种算法共用，只有正常跟线分支按算法
    分岔。新增BT命令 algo bangbang/pid、pid kp/ki/kd N，纳入config_module
    持久化。三个默认增益(Kp40/Ki0/Kd5)未经实车验证，需现场试调，
    DESIGN.md补充设计说明和风险记录。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
    [cmd_module.cpp, config_module.cpp, config_module.h, sensor_module.cpp, sensor_module.h, track_module.cpp, track_module.h]
2026-07-22 debug: 新增BT连接状态诊断log，排查更新后BT连不上的问题
    开机打印"BT started: LineTrace"确认程序跑到了bt_begin()；loop()里每秒
    打印一次当前连接状态"BT connected"/"ERROR: BT not connected"（用周期性
    打印而非状态变化触发，因为"一直连不上"这种从头到尾没有变化的场景，边沿
    触发的log永远不会打印）。顺带在README.txt更正了LED行为的过时描述：
    GPIO2实际是常亮/常灭跟随bt_connected()，不是"快闪/慢闪"。
    [sensor_debug.ino]
2026-07-22 feat: 新增Flash文件log(/track.log)，应对BT连接不稳定；file_log开关纳入持久化
    print_module新增第三个输出通道，track_module调试log正常走out()即可同时写入
    文件，为不拖慢track_update()实时性，先攒1KB内存缓冲区再落盘，文件大小上限
    256KB防止写满flash。新增命令print file on/off、log dump/clear/status。
    file_log开关状态纳入config_module持久化（json新增file_log字段），save后
    重启自动恢复上次的开关状态。
2026-07-22 fix: BT连接诊断log改为开机打印一次+状态变化时打印，避免刷屏
    之前每秒周期性打印一次BT连接状态，未连接时会一直刷屏。改为
    last_bt_state初始值设为-1（不是0/1），开机后第一次loop必然触发一次
    初始状态打印，之后只在连接/断开状态真正变化时才打印。
    [sensor_debug.ino]
2026-07-22 docs: 合并README.txt到DESIGN.md，文档统一维护为一份
    README.txt的硬件平台/引脚定义/传感器阈值/电源/代码结构/BT命令列表/依赖库/
    待完成清单，合并进DESIGN.md最上方新增的"硬件参考"+"代码结构与命令参考"+
    "待完成清单"三节；DESIGN.md原有的按主题分节决策记录保留不变。同时补充了
    之前PID/文件log功能加入时遗漏更新的config_module/track_module模块说明，
    删除README.txt。
2026-07-22 fix: log dump大文件时yield()避免触发任务看门狗复位
    实测log-3.txt(193KB)时print_file_dump()连续Serial.write()约17秒无yield，
    触发ESP32任务看门狗复位，dump只打印出约18%就被打断。循环里加yield()修复，
    DESIGN.md待完成清单补充记录。
    [print_module.cpp]
2026-07-29 5路传感器算法
    [ロボコン_配布品リンク.xlsx]
2026-07-29 8路传感器
2026-07-29 8路模拟上库
    [8路模拟.xlsx]
2026-07-31 20260731:log功能修改
2026-08-09 方案A弯道分档降速+minpwm防堵转，log13~20分析及设计文档
    代码(sensor_debug/):
    - track_module: bang-bang各转向档按前进速度系数整档降速(medspeed/sharpspeed/hairpinspeed)，
    外轮加minpwm最小前进PWM地板防静摩擦堵转，sharp/发卡内轮反转保持满速base掉头力度；
    PID与丢线找线不动，两套分开
    - cmd/config: 新增mediumspeed/sharpspeed/hairpinspeed/minpwm运行时命令+持久化+PARAMS日志字段
    - print: LOG_LINE_MAX 320->384(容纳新PARAMS字段)
    文档:
    - log分析/log13~20分析.md: 直线攻克(slew/PID)到弯道(方案A受电机死区限制动不了sharp/发卡)全过程
    - 如何判断当前有没有机械延迟.md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
2026-08-09 文档整理：全部 md 归入 doc/ 并按类别分目录
    - doc/设计/ 架构与算法（设计说明/调用流程/8路方案/PID/BANGBANG/LOG精简）
    - doc/硬件/ 电机选型/电池/传感器前探/机械延迟判定
    - doc/调试/ 调试记录/软件问题解决
    - doc/日志分析/ logNN.txt 原始数据 + logNN分析.md（整个log分析目录迁入）
    - doc/其他/ WIFI_PLAN
    - doc/README.md 分类索引（含各文档一句话说明+关键脉络）
    文件用 git mv 迁移，保留历史；根目录不再散落 md。
2026-08-09 算法管理单元：多命名算法档案(id+name+base+参数)，可管理/切换/持久化
    - track_module: 以 AlgoEntry[8] + 激活id 取代原双档案；新增 algo 管理API
    (use/new/copy/rename/del/list-accessor)，切换即换整套参数并切控制律，热切换清PID历史
    - cmd_module: 新增 algolist/algouse/algonew/algocopy/algoname/algodel 命令；
    algo 0/1 保留为别名；algolist 激活行展开显示全部参数
    - config_module: config.json 改为 {active,file_log,标定[],algos:[{id,name,base,...params}]}，
    向后兼容旧扁平/bb-pid 格式；config 打印改为分节分行(先共用参数、后算法参数)可读视图；
    PARAMS 日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
2026-08-09 日志解析器: Excel 顶部参数区块 + CH8->CH1 列序; 双击launcher; 解析答疑
    - doc/日志分析/parse_logs.py: 支持双击(无参->tkinter选文件->同名xlsx),
    表头上方增加"全部参数"区块(每个TRACK_ON段一行,含thresh/white/black),
    CH列改为 CH8..CH1 (物理左->右, 与车上一致), white_chs 同步左->右
    - doc/日志分析/解析log.bat: 双击启动(pythonw, 无控制台)
    - doc/日志分析/log解析答疑.md: Q1 决策vs执行/slew, Q2 线偏哪追哪(方向), Q3 slew_rate详解
    - .gitignore: 忽略 doc/日志分析/*.xlsx (可重生成) + __pycache__/*.pyc
2026-08-09 cross判定收紧 + lograte可配置采样(只写内存) + 修loop周期性卡顿(去掉out()的flash写)
    - track_module: cross 改为 far_left(CH7/8) && far_right(CH1/2)，居中CH4+CH5不再误判为十字；
    新增 lograte(内存日志采样周期,默认10ms,运行时可调)取代写死的500ms心跳；
    记录路径去掉 out_usb/out_bt，只写RAM(高频采样不拖慢loop、不刷屏)
    - print_module: out() 去掉 out_file() —— loop里的LOOP统计/200ms块不再周期性写flash
    (那是loop周期性卡顿50~211ms的根因，见 doc/问题/01)；track off一次性落盘不受影响
    - ram_log_module: flush落盘时临时开_file后【还原】，不再粘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
    [cmd_module.cpp, config_module.cpp, print_module.cpp, ram_log_module.cpp, track_module.cpp, track_module.h]
2026-08-09 日志分析: log25(卡顿修复实测) / log26-27(速度18v19) / log28(PID遇左弯即飞)
    - log25分析.md: 烧入卡顿修复后, 10ms采样全程10~11ms零卡顿, 98s无撞停; 问题01标记已解决
    - log26-27分析.md: 算法管理器建bb_18/bb_19做speed对比, 19比18更marginal(丢线22%vs19.6%);
    持续偏左(LOST_L>>LOST_R)
    - log28分析.md: PID(kp80/kd15/spd15)~2s遇左弯即飞。根因=PID的base+output把外轮顶到2.4×base、
    加速冲进弯过冲丢线(bb外轮≤base还降速,恰相反); kd尖峰火上浇油; 建议外轮封顶/按err降base
    - 原始 log26/27/28.txt
2026-08-10 PID分支外轮封顶在base:修正量只减慢内轮(可反转),外轮不加速冲弯
    对称的 base±output 会把外轮顶到2倍多base,加速冲进弯过冲丢线(见 问题/02)。
    改为外轮封顶base、只减慢内轮;BB分支不动。
    [track_module.cpp]
2026-08-10 日志分析: log29/30/31 及分析文档
2026-08-10 传感器阈值自动标定方案(设计) + PID分析/日志汇总文档更新
    - 新增 doc/设计/传感器阈值自动标定方案.md: 扫描式自动标定
    whiteref/blackref/threshold, top-K/bottom-K 极值群平均,
    MAX_K容量+运行期可配K, 结果表显示N/nBlack/nWhite,
    save 与 savesensor 拆分(传感器值独立存)
    - 更新 doc/设计/PID算法分析.md
    - 新增 doc/日志分析/汇总.md
2026-08-10 传感器阈值自动标定(方案B): calib sweep扫描式标定 + 传感器值独立存/sensor.json
    - sensor_module: 新增扫描式自动标定 sensor_calib_sweep()，手持横扫黑线采集
    100Hz样本，每路取最大K个均值=blackref/最小K个均值=whiteref，
    threshold=white+(black-white)*ratio；极值群用升/降序数组，采集缓冲malloc临时申请
    用完即free(不进永久内存)；校验不过的路保留旧值并打结果表
    - config_module: config_save()不再写传感器数组，改存calib_k/ratio/sweep标量；
    新增config_save_sensor(mask)写/sensor.json；config_begin()优先读/sensor.json，
    无则从旧config.json内嵌数组一次性迁移(向后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
